wxyhaha/FlipPomodoroTimer/hardware/enclosure/FINAL-DIMENSIONS-V12.9.md

# V12.9 最终名义尺寸核对与下单文件

本次仅把两个压条前舌加长并将对应盲槽改为通孔。通孔下方增加拆装让位，不改上沿防抬位置。与V12.8的实体布尔差异检查显示，主壳与压条的差异全部在这两个卡口区域，后盖几何差异为零。详细记录见 `scope-check.json`。这是一份模型核查，不是实物或代打精度保证。

## 最新正式打印件

`hardware/enclosure/v12.9/` 中，以下三件各打印1个，单位mm：

| 文件 | 部件 | 打印摆放包络（mm） |
| --- | --- | --- |
| V12.9-shell.stl | 一体主壳，包含托槽、导轨和螺丝座 | 90.5×92.5×90.5 |
| V12.9-lid.stl | 四螺丝后盖 | 90.5×92.5×6 |
| V12.9-retainer.stl | 一件U形电池压条 | 50×57.8×19.3 |

正式文件是源码输出 `v12/*-print.stl` 的同几何版本命名副本。三个打印件均已摆放落在Z=0，全部为单一封闭实体；试样、装配坐标版本和GLB不得重复当正式件下单。

## 尺寸清单

| 项目 | 名义尺寸/间隙 |
| --- | --- |
| 总装包络（宽×深×高） | 90.5×94.5×92.5mm |
| 目标面板 | 86.5×86.5×14.5mm |
| 面板内缩 | 3mm |
| 面板槽 | 高86.90mm、前后深14.90mm；上下、前后每侧0.2mm |
| 面板左侧 | 上、下各4mm止挡；左缘名义间隙0.05mm；中部78.5mm开放 |
| 面板后侧导轨 | 上下各搭边2mm；后隙0.2mm；右侧约0.3mm导入斜口 |
| 前框 | 前口78mm，最窄内口72.8mm；圆角内口R0.8mm |
| 官方显示区 | 71.93×71.93mm，按居中建模；直边余量每侧0.435mm |
| 电池 | 含包膜66.7×37.3×20mm；左右各约0.8mm，前端2.8mm、后端0.8mm余量 |
| 电池压条 | 两条臂宽6mm、厚2.5mm；电池顶面间隙0.5mm |
| 新长舌 | 两个，宽6mm、厚1.2mm；从内侧立臂向前伸3mm，穿过2mm挡边，外露1mm；根部另有0.1mm连接重叠 |
| 新通孔 | 宽6.6mm、高2.4mm；舌片左右各0.3mm、上方0.2mm、下方1.0mm装拆让位 |
| 长舌尖到面板背面 | 约9.7mm（不含实际插座和线束） |
| 压条立臂到电池前侧 | 约1.3mm（就位状态） |
| 后盖 | 外板厚4mm；定位边伸入2mm、名义单边间隙0.3mm |
| 螺丝 | 塑料用自攻外径约3mm×头下长10mm，共6颗：后盖4、压条2；不使用螺母 |
| 螺丝孔 | 通孔3.2mm、导孔2.5mm；后盖沉台6.4mm直径×2.2mm深；螺丝头要求直径≤6mm、高≤2mm |

## 检查结果和实际限制

- 三件封闭、正体积、各单一实体；装配位置的实体之间及对面板/电池标称包络均无正体积穿插。
- 面板右侧三个插入位置检查通过，向左0.2mm移动会被止挡阻挡；后移超过0.2mm的检查会被后导轨限制。
- 新通孔贯通检查、尺寸和范围差异检查通过；面板后侧到电池仓的九条射线贯通。
- 屏幕9种正视偏移场景无挡；81种全部场景中，14种极限偏移叠加30°斜视仍有少量遮边，用户已接受，开口未改。
- 压条拆装检查使用移开面板、后盖的顺序，并把电池近似为20mm厚、37.3mm宽、66.7mm长的圆柱包络。1071个采样姿态未发现穿插，可逆向用于装配。不是带实际线束、包膜起伏和手部操作的实物验证。
- 长舌需要先插前端、再落后端并上两颗螺丝；拆卸先移开面板和后盖、卸压条螺丝，逐步倾斜并后退，再从后方取出。不能把“露出1mm”理解为可以平着强拉3mm，也不能强掰树脂舌片。
- 面板右端仍没有防退出锁，打印收缩、胶膜、线束、螺丝攻入及材料强度没有实物验证。几何检查不能保证打印后免修配；这些既有结构未在本次修改中调整。
