wxyhaha/FlipPomodoroTimer/docs/CODE-REVIEW-2026-11-06.md

# 固件检查与当前限制

固件实现已覆盖计时状态、电源、触摸、显示和音频的主要交互；当前功能及实际验证范围见[功能状态与验收说明](UI-V6-VALIDATION.md)。

仍需注意：RTC 底层 I2C 读取错误未完整向应用层传播；充电电流、完整充电周期与续航尚未实测；屏幕、音频和电源相关并发行为仍需在完整设备上进一步覆盖。编译及短时运行不等同于所有场景均已通过。
