wxyhaha/FlipPomodoroTimer/docs/PLAN.md

# 项目成果与复现状态

项目已形成立式翻转番茄钟实物：触摸屏开发板、电池组、定制打印主壳、后盖和电池压条已装配；实物照片与演示见[项目首页](../README.md)。

| 内容 | 当前状态 |
| --- | --- |
| 番茄钟、时钟页与翻面 | 固件已实现，视频展示翻面切换、显示旋转和页面切换 |
| 用户输入与提示音 | 触摸、BOOT、PWRKEY、电钢琴提示音均已实现；具体操作见首页和[提示音说明](AUDIO.md) |
| 电池与 USB | 已观察短时电池供电和 USB 接入时芯片报告充电；完整充电周期、实际电流、容量与续航未测 |
| 外壳 | X 树脂外壳已打印并装配；实物照片展示内部与后盖，长期防脱、螺丝配合和线束可靠性仍需验证 |
| 最新固件 | 已编译并烧录，写入校验通过；USB 插拔规则、电量图标及动画在更多场景下仍需实机验收 |

## 构建配置

使用 Arduino CLI 1.5.1、`esp32:esp32@3.3.11`，目标 `esp32:esp32:esp32s3`，Flash 16MB、OPI PSRAM，仓库本地依赖通过 `--libraries firmware/libraries` 指定。完整命令与 Wi-Fi 本地配置说明见[项目首页](../README.md)。

公开分发二进制之前，应在不含 `WiFiConfig.local.h` 的环境构建；项目许可证、第三方库与字库许可、干净环境复现仍需另行核实。
