wxyhaha/FlipPomodoroTimer/docs/design/UI-DESIGN.md

# 最终界面

番茄钟页采用 20 段彩色时间环与自绘数码字；时钟页采用大号时分、小号秒数、中文日期和星期。顶部左右分别为番茄钟和时钟入口，中间显示电池状态及百分比，左下角提供息屏入口。

显示方向根据姿态旋转，静止状态使用局部刷新；动画使用较小纹理以兼顾性能，最终画面恢复原生分辨率。实际画面和操作请看[成品照片与演示](../../README.md)，具体验证边界见[功能状态与验收说明](../UI-V6-VALIDATION.md)。
