wxyhaha/FlipPomodoroTimer/docs/design/timer-clock-ui-v2.png

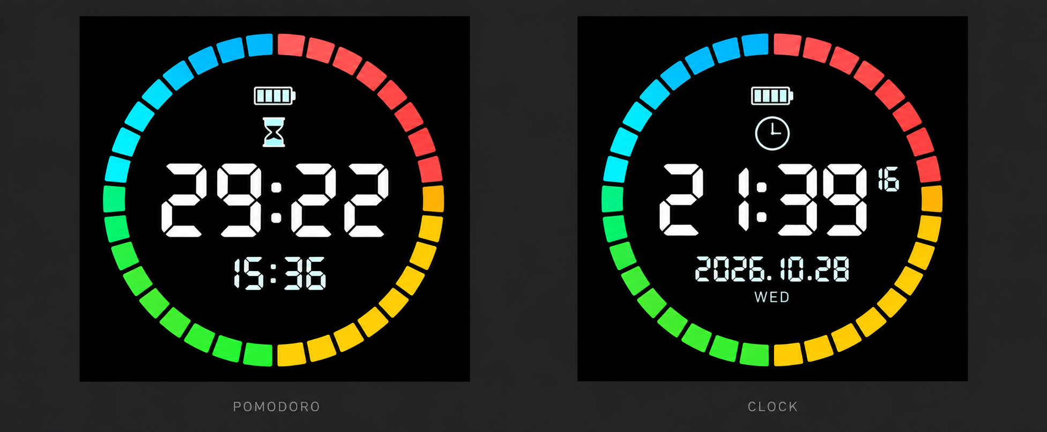
docs/design/timer-clock-ui-v2.png
