wxyhaha/FlipPomodoroTimer/docs/design/timer-clock-ui-v3.png

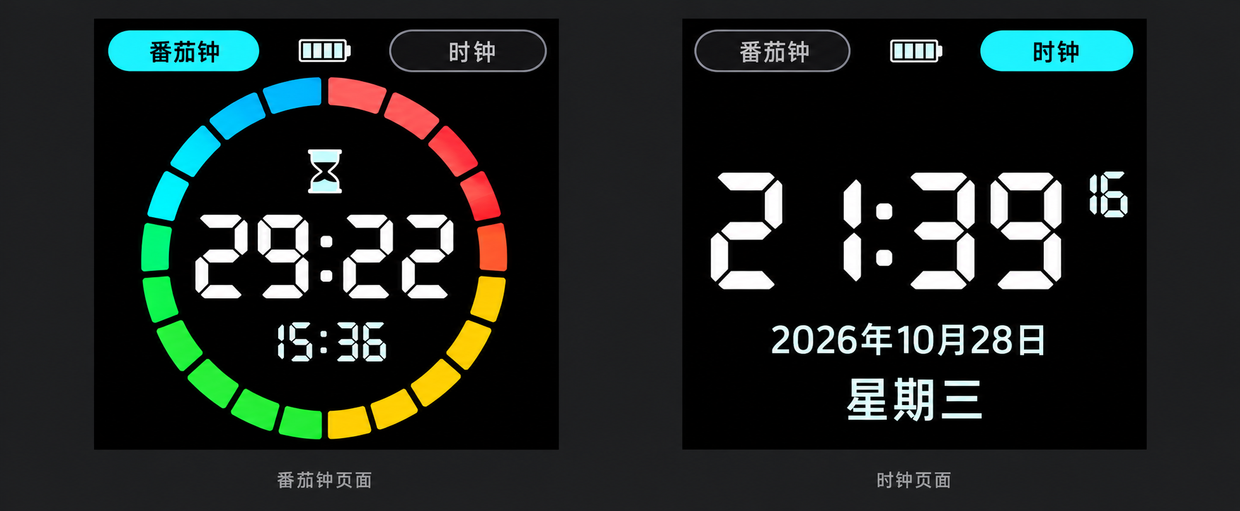
docs/design/timer-clock-ui-v3.png
