wxyhaha/FlipPomodoroTimer/docs/design/timer-clock-ui-v4.png

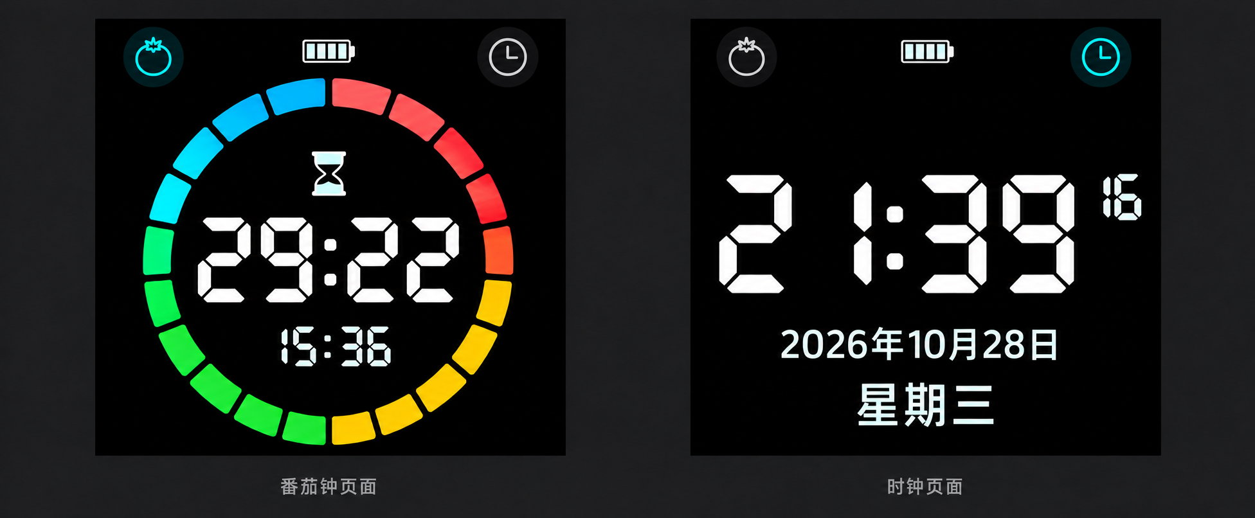
docs/design/timer-clock-ui-v4.png
