wxyhaha/FlipPomodoroTimer/docs/design/timer-ui-v1.png

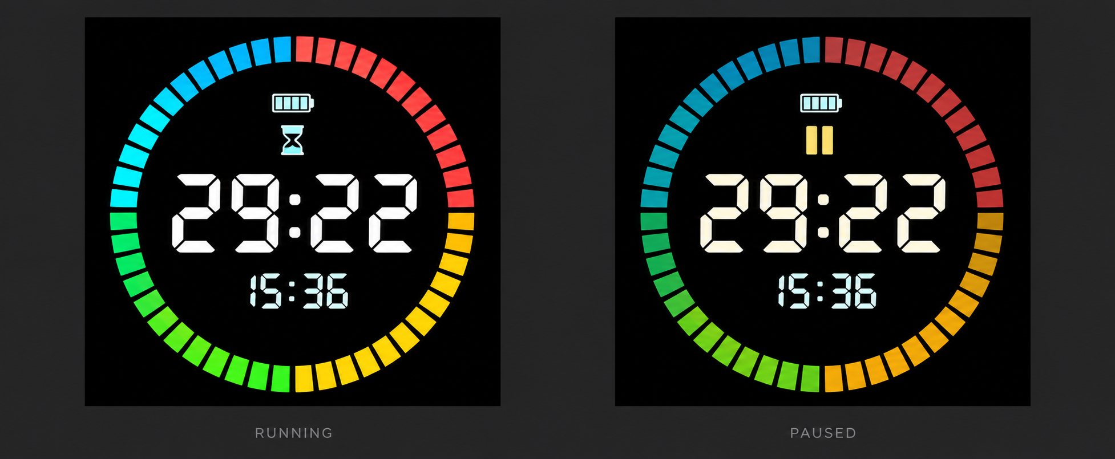
docs/design/timer-ui-v1.png
