wxyhaha/FlipPomodoroTimer/hardware/enclosure/enclosure-v0.png

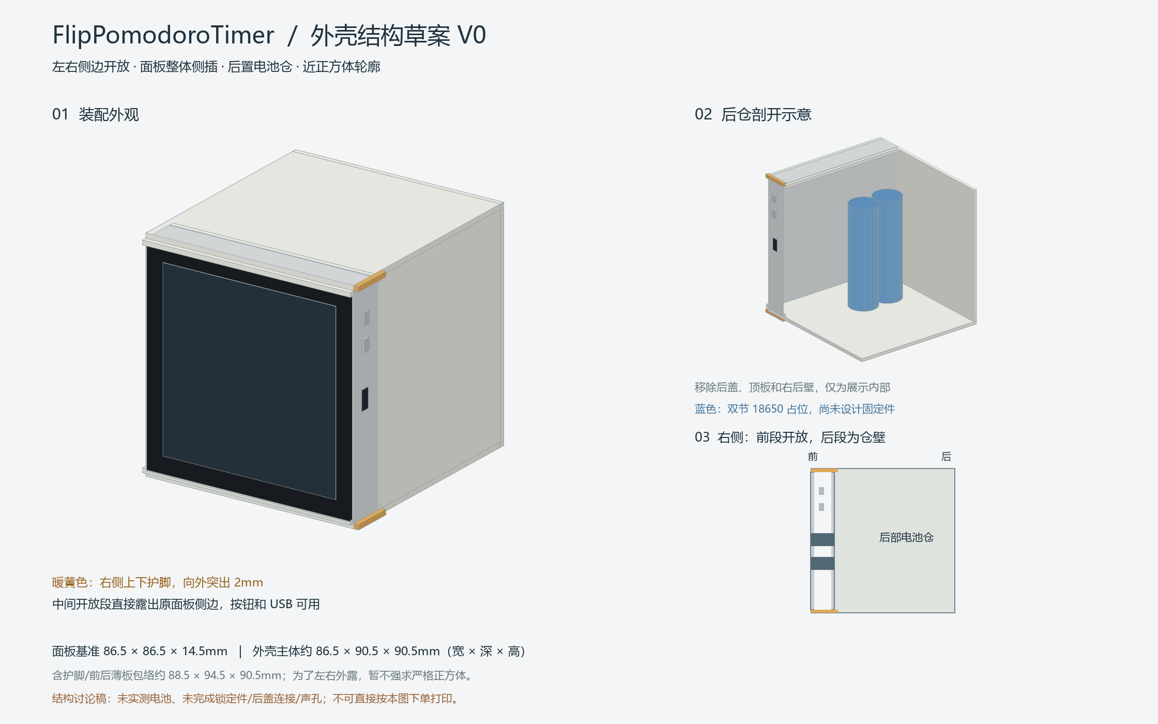
hardware/enclosure/enclosure-v0.png
