wxyhaha/FlipPomodoroTimer/hardware/enclosure/v12.9/V12.9-shell.stl

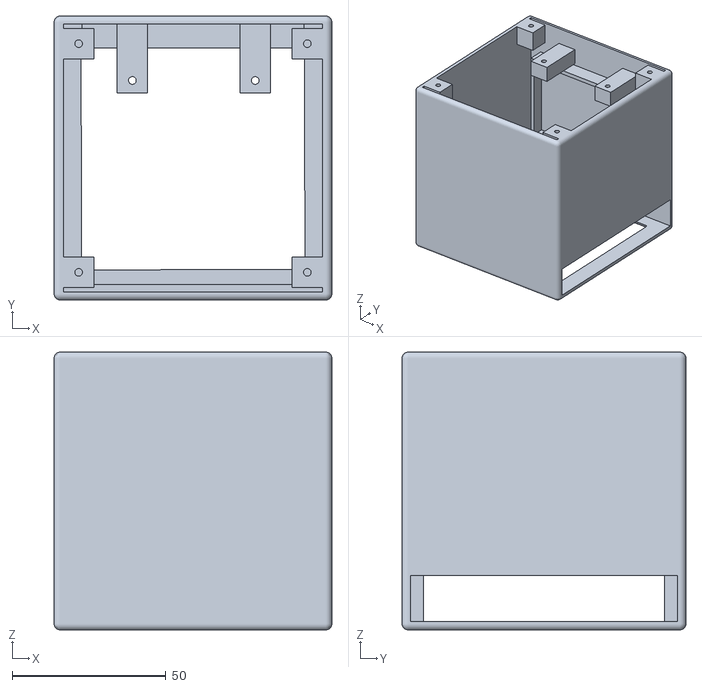
[picture p14: CAD file, 2026-11-03]
hardware/enclosure/v12.9/V12.9-shell.stl
90.5 x 92.5 x 90.5
