wxyhaha/FlipPomodoroTimer/hardware/enclosure/v12.9/V12.9-lid.stl

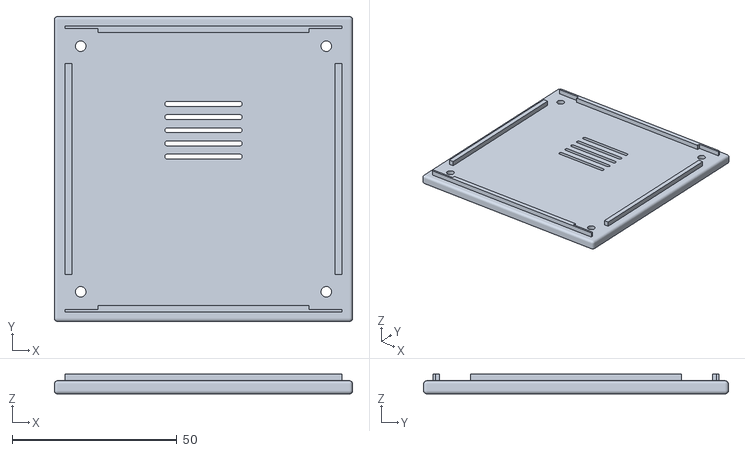
[picture p15: CAD file, 2026-11-03]
hardware/enclosure/v12.9/V12.9-lid.stl
90.5 x 92.5 x 6.00
