wxyhaha/FlipPomodoroTimer/hardware/enclosure/v12/retainer-assembly.stl

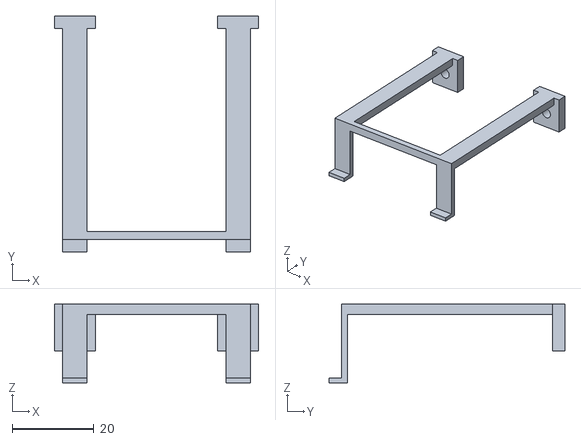
[picture p16: CAD file, 2026-11-03, an earlier design]
hardware/enclosure/v12/retainer-assembly.stl
50.0 x 57.8 x 19.3
