wxyhaha/FlipPomodoroTimer/hardware/enclosure/v12/fit-tongue.stl

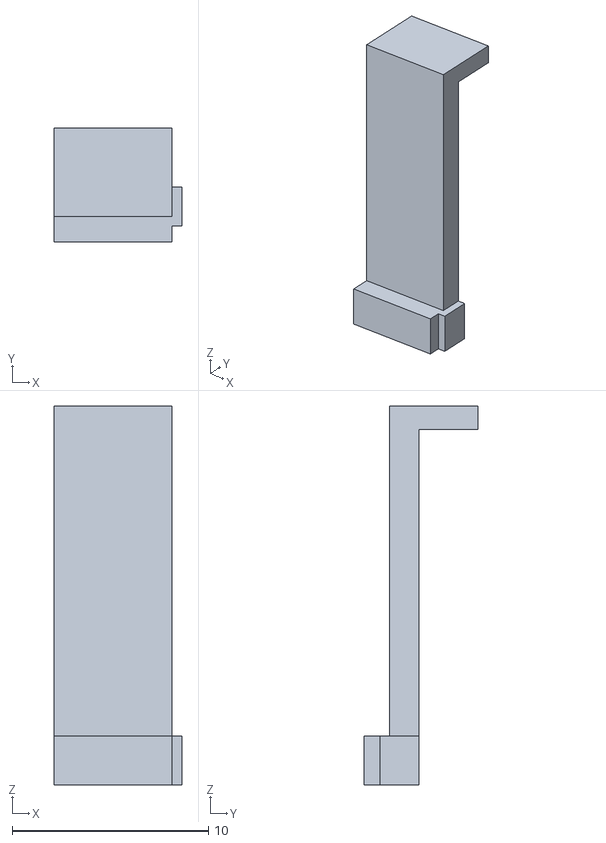
[picture p17: CAD file, 2026-11-03, an earlier design]
hardware/enclosure/v12/fit-tongue.stl
6.50 x 5.80 x 19.3
