wxyhaha/FlipPomodoroTimer/hardware/enclosure/v12/fit-rail.stl

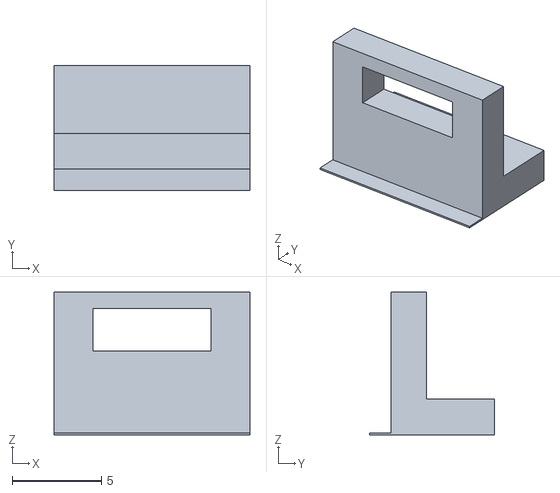
[picture p18: CAD file, 2026-11-03, an earlier design]
hardware/enclosure/v12/fit-rail.stl
11.0 x 7.00 x 8.00
