wxyhaha/FlipPomodoroTimer/hardware/enclosure/v12/fit-panel-guide.stl

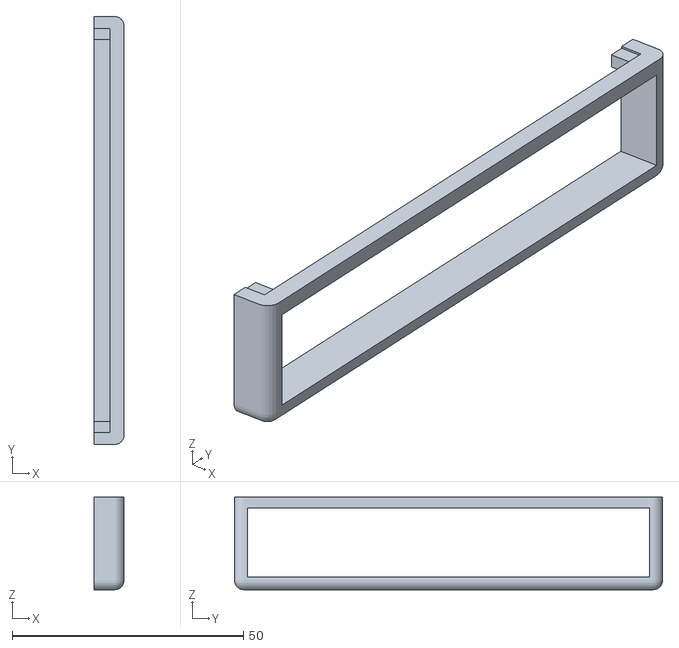
[picture p19: CAD file, 2026-11-03, an earlier design]
hardware/enclosure/v12/fit-panel-guide.stl
6.50 x 92.5 x 20.0
