wxyhaha/FlipPomodoroTimer/hardware/enclosure/v12/fit-panel-slot.stl

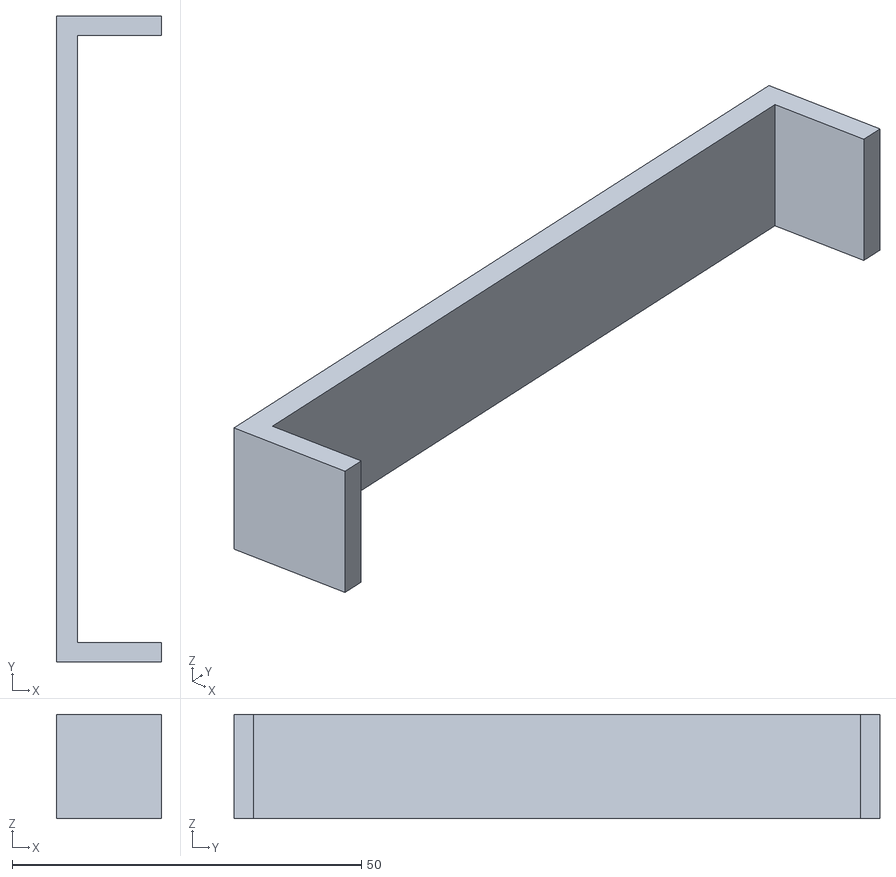
[picture p20: CAD file, 2026-11-03, an earlier design]
hardware/enclosure/v12/fit-panel-slot.stl
15.0 x 92.5 x 14.9
