wxyhaha/FlipPomodoroTimer/hardware/enclosure/v12/fit-screws.stl

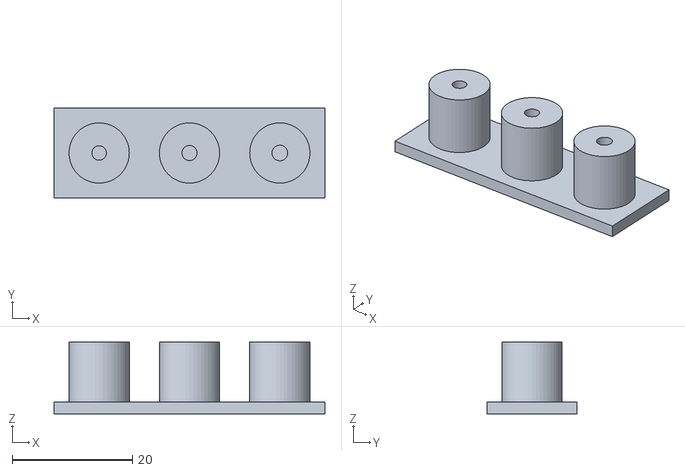
[picture p21: CAD file, 2026-11-03, an earlier design]
hardware/enclosure/v12/fit-screws.stl
45.0 x 15.0 x 11.9
