wxyhaha/FlipPomodoroTimer/(list of files, cad)

Other CAD files:
hardware/enclosure/v12/shell-assembly.stl
hardware/enclosure/v12/lid-assembly.stl
hardware/enclosure/v12/retainer-print.stl
hardware/enclosure/enclosure-v0.scad
hardware/enclosure/enclosure-v1.scad
hardware/enclosure/enclosure-v10.scad
hardware/enclosure/enclosure-v2.scad
hardware/enclosure/enclosure-v3.scad
hardware/enclosure/enclosure-v4.scad
hardware/enclosure/enclosure-v5.scad
hardware/enclosure/enclosure-v6.scad
hardware/enclosure/enclosure-v7.scad
hardware/enclosure/enclosure-v8.scad
hardware/enclosure/enclosure-v9.scad
