wxyhaha/FlipPomodoroTimer/docs/UI-V5-VALIDATION.md

# 界面与验收

当前界面与验证状态统一见[功能状态与验收说明](UI-V6-VALIDATION.md)，实物照片及演示见[项目首页](../README.md)。
