wxyhaha/FlipPomodoroTimer/firmware/FlipPomodoroTimer/FlipPomodoroTimer.ino

#include <Arduino.h>
#include <Wire.h>
#include "pin_config.h"
#include "PomodoroState.h"
#include "IMUSensor.h"
#include "PowerManager.h"
#include "DisplayUI.h"
#include "InputManager.h"
#include "AudioManager.h"
#include "RTCManager.h"

#include "WiFiConfig.h"

// Wi-Fi 配置来自忽略的本地文件；未配置时离线运行。



PomodoroEngine engine;
IMUSensor imu;
PowerManager power;
DisplayUI ui;
InputManager input;
AudioManager audio;
RTCManager rtc;

unsigned long lastTelemetryTime = 0;
bool stableVbusIn = false;
bool candidateVbusIn = false;
bool startIdleTimerAfterUnplug = false;
unsigned long vbusCandidateSince = 0;
constexpr unsigned long USB_MODE_DEBOUNCE_MS = 1000;

void updateUsbMode(unsigned long now) {
  if (power.vbusIn != candidateVbusIn) {
    candidateVbusIn = power.vbusIn;
    vbusCandidateSince = now;
  }

  if (candidateVbusIn == stableVbusIn || now - vbusCandidateSince < USB_MODE_DEBOUNCE_MS) return;

  stableVbusIn = candidateVbusIn;
  if (stableVbusIn) {
    startIdleTimerAfterUnplug = false;
    if (engine.state == STATE_FOCUS_RUNNING || engine.state == STATE_BREAK_RUNNING) {
      // USB power must not interrupt an active countdown or change its page.
      Serial.println("[POWER] USB connected during countdown; keep timer and page");
    } else {
      ui.setMode(UI_MODE_CLOCK);
      Serial.println("[POWER] Stable USB input -> Clock page");
    }
  } else {
    if (engine.pauseReason == PAUSE_BY_USB) engine.pauseReason = PAUSE_BY_USER;
    ui.setMode(UI_MODE_POMODORO);
    startIdleTimerAfterUnplug = engine.state == STATE_IDLE;
    Serial.println("[POWER] USB input removed -> Pomodoro page");
  }
}

void setup() {
  Serial.begin(115200);
  delay(300);

  Serial.println("\n==================================================");
  Serial.println("  Cube Flip Clock & Timer (ESP32-S3-Touch-LCD-4B)");
  Serial.println("==================================================");

  // 1. 初始化 I2C 总线
  Wire.begin(BOARD_I2C_SDA, BOARD_I2C_SCL);

  // 2. 初始化显示屏 (原生全中文支持，480x480 RGB)
  Serial.print("Init Display... ");
  if (ui.init()) {
    Serial.println("OK");
    ui.showBootScreen();
  } else {
    Serial.println("FAILED!");
  }

  // 3. 初始化电源管理 (AXP2101 + 100% 满血高亮背光)
  Serial.print("Init Power Manager... ");
  if (power.init()) {
    Serial.println("OK");
  } else {
    Serial.println("FAILED!");
  }

  // 4. 初始化硬件 RTC 并通过 Wi-Fi NTP 自动授时
  Serial.print("Init RTC & WiFi NTP Sync... ");
  if (rtc.init()) {
    Serial.println("OK");
    // 尝试连接用户 Wi-Fi 并同步网络时间，授时完成后立即关闭 Wi-Fi 节能
    rtc.syncTimeWithWiFi(WIFI_SSID, WIFI_PASS, 8000);
  } else {
    Serial.println("FAILED!");
  }

  // 5. 初始化六轴姿态传感器 (QMI8658 陀螺仪与加速度计)
  Serial.print("Init QMI8658 IMU... ");
  if (imu.init()) {
    Serial.println("OK");
  } else {
    Serial.println("FAILED!");
  }

  // 7. 初始化触控与按键 (GT911 & BOOT Pin)
  Serial.print("Init Input (Touch & Button)... ");
  if (input.init()) {
    Serial.println("OK");
  } else {
    Serial.println("FAILED!");
  }

  // 8. 初始化音频提示 (ES8311 Codec 最大音量提示音)
  Serial.print("Init Audio (ES8311 Codec)... ");
  if (audio.init(ui.getExpander())) {
    Serial.println("OK");
  } else {
    Serial.println("DISABLED/NOT FOUND");
  }

  // 9. 初始化番茄钟状态机
  engine.begin();

  // Startup page follows the current USB input; timer state remains independent.
  stableVbusIn = candidateVbusIn = power.vbusIn;
  vbusCandidateSince = millis();
  ui.setMode(stableVbusIn ? UI_MODE_CLOCK : UI_MODE_POMODORO);

  // 根据启动时的初始姿态自动校准屏幕显示方向
  uint8_t initialRotation = imu.getDisplayRotation(0);
  ui.setRotation(initialRotation);
  input.setRotation(initialRotation);

  if (imu.isFlippedDown()) ui.setPanelOutputOff(true, power);
  delay(400);

  // 首次完整绘制拟真科技感全界面
  ui.fullRedraw(engine, imu, power, rtc);
  Serial.println("System Ready! UI V6.2 - full panel off, PWRKEY double-click shutdown.\n");
}

void loop() {
  unsigned long now = millis();

  // Sound cues are dispatched once, after all state changes in this loop.
  TimerState stateAtLoopStart = engine.state;
  uint8_t faceAtLoopStart = engine.activeFace;
  engine.tick(now);

  // Optional serial speaker check; no changes to timer duration/state.
  static char command[24] = {};
  static uint8_t commandLength = 0;
  for (int budget = 0; budget < 32 && Serial.available(); ++budget) {
    char c = Serial.read();
    if (c == '\n' || c == '\r') {
      command[commandLength] = 0;
      if (!strcmp(command, "AUDIO_TEST")) audio.playTest();
      commandLength = 0;
    } else if (commandLength < sizeof(command) - 1) command[commandLength++] = c;
    else commandLength = 0;
  }

  // 2. 轮询电源状态（USB 插拔、电量）
  power.update();
  if (power.updatePowerKeyDoubleClick(now)) {
    Serial.println("[POWER] PWRKEY double-click -> full shutdown");
    audio.stop();
    power.shutdown();
  }
  bool previousStableVbus = stableVbusIn;
  updateUsbMode(now);

  // 3. 推进硬件 RTC 时间走时
  rtc.update(now);

  // 4. 轮询姿态传感器（125Hz 采样与 600ms 滤波）
  bool oriChanged = imu.update();

  // Visual direction is independent of the 600ms timer-face confirmation.
  uint8_t targetRot = imu.getVisualRotation(ui.getRotation());
  if (targetRot != ui.getRotation()) {
    ui.setRotation(targetRot);
    input.setRotation(targetRot);
    Serial.printf("[DISPLAY] 2D direction -> %u deg\n", targetRot * 90);
  }

  // 6. 姿态发生稳态切换事件
  if (oriChanged) {
    Serial.printf("[IMU] Orientation Changed -> %s (ax=%.2f, ay=%.2f, az=%.2f, roll=%.1f deg)\n",
                  imu.getOrientationName(), imu.ax, imu.ay, imu.az, imu.smoothRollAngle);

    if (imu.isFlippedDown()) {
      ui.setPanelOutputOff(true, power);
      // 动作：设备屏幕完全朝下盖在桌面上，关闭显示输出并暂停计时。
      if (engine.state == STATE_FOCUS_RUNNING || engine.state == STATE_BREAK_RUNNING) {
        Serial.println("[POMO] Auto Pause by Flip Down (Panel Off)");
        engine.pause(PAUSE_BY_FLIP);
      } else if (engine.state == STATE_COMPLETED) {
        Serial.println("[POMO] Confirm Completed by Flip Down");
        engine.confirmCompleted();
      }
    } else if (imu.isBackwardPaused()) {
      // 动作：向后翻转平放在桌面上（用户核心需求：向后翻转暂停，保持 100% 满血高亮以便看清状态）
      if (!ui.isManualScreenOff()) ui.setPanelOutputOff(false, power);
      if (engine.state == STATE_FOCUS_RUNNING || engine.state == STATE_BREAK_RUNNING) {
        Serial.println("[POMO] Auto Pause by Backward Flip!");
        engine.pause(PAUSE_BY_FLIP);
      } else if (engine.state == STATE_COMPLETED) {
        Serial.println("[POMO] Confirm Completed by Backward Flip");
        engine.confirmCompleted();
      }
    } else if (imu.isTiltedFace()) {
      // 动作：设备立在 4 个侧立面之一
      if (!ui.isManualScreenOff()) ui.setPanelOutputOff(false, power);
      uint8_t face = imu.getFaceIndex();
      unsigned long faceSec = imu.getFaceDurationSec();

      // 番茄钟页立到新面或待机/完成后重新立起时，切换到该面的独立倒计时。
      if (ui.getMode() == UI_MODE_CLOCK || engine.pauseReason == PAUSE_BY_USB) {
        // 时钟页下翻面只更新屏幕方向，不启动隐藏倒计时或切换页面；
        // USB 自动暂停期间移动也不覆盖保留的剩余时间。
      } else if (engine.activeFace != face || engine.state == STATE_IDLE || engine.state == STATE_COMPLETED) {
        Serial.printf("[POMO] Tilt to New Face %u (%lu sec) -> Start Timer!\n", face, faceSec);
        engine.startFace(face, faceSec);

      } else if ((engine.state == STATE_FOCUS_PAUSED || engine.state == STATE_BREAK_PAUSED) &&
                 engine.pauseReason == PAUSE_BY_FLIP) {
        // 同一个面从暂停中重新立起恢复
        Serial.printf("[POMO] Tilt back to Same Face %u -> Resume Timer!\n", face);
        engine.resume();
      }
    }
  }

  // A face may already be stable when USB is removed, so no orientation-change
  // event will arrive. Wait for a confirmed side rather than starting while moving.
  if (startIdleTimerAfterUnplug) {
    if (stableVbusIn || engine.state != STATE_IDLE || ui.getMode() != UI_MODE_POMODORO) {
      startIdleTimerAfterUnplug = false;
    } else if (imu.isReady && imu.isTiltedFace() &&
               imu.candidateOrientation == imu.currentOrientation &&
               millis() - imu.candidateStartTime >= IMUSensor::STABLE_DURATION_MS) {
      engine.startFace(imu.getFaceIndex(), imu.getFaceDurationSec());
      startIdleTimerAfterUnplug = false;
      Serial.println("[POMO] USB removed -> start current stable face");
    }
  }

  // 7. 轮询触摸与物理按键输入
  if (ui.isAnimating()) input.cancelTouch();
  UserAction action = input.update();
  if (action == ACTION_TAP && ui.isAnimating() && !input.lastTapFromButton) {
    action = ACTION_NONE; // Ignore moving touch targets until rotation settles.
  }
  if (action == ACTION_TAP) {
    Serial.printf("[USER] Tap Event at (%d, %d)\n", input.lastTapX, input.lastTapY);

    // A tap while blank only wakes the display; it must not also toggle the timer.
    if (ui.isManualScreenOff()) {
      ui.setManualScreenOff(false);
      if (!imu.isFlippedDown()) ui.setPanelOutputOff(false, power);
      Serial.println("[UI] Wake display by touch");
    } else if (ui.checkScreenOffClick(input.lastTapX, input.lastTapY)) {
      ui.setManualScreenOff(true);
      ui.setPanelOutputOff(true, power);
      Serial.println("[UI] Manual panel off; tap anywhere to wake");
    } else {
      int clickedMode = ui.checkBadgeClick(input.lastTapX, input.lastTapY);
      if (clickedMode >= 0 && !input.lastTapFromButton) {
        if (clickedMode != (int)ui.getMode()) {
          ui.setMode((UIMode)clickedMode);
          Serial.printf("[UI] Mode Switched to %s\n", (clickedMode == UI_MODE_CLOCK) ? "CLOCK" : "POMODORO");
          audio.playClickTone();
        }
      } else if (input.lastTapFromButton || ui.getMode() == UI_MODE_POMODORO) {
        // Timer page tap / physical BOOT toggles timer; clock page background is inert.
        engine.toggle();
        if (engine.state != STATE_FOCUS_RUNNING && engine.state != STATE_BREAK_RUNNING) audio.playClickTone();
      }
    }
  } else if (action == ACTION_LONG_PRESS) {
    Serial.println("[USER] Long Press Event -> RESET TIMER");
    audio.stop();
    audio.playClickTone();
    engine.reset();

  }

  bool wasRunning = stateAtLoopStart == STATE_FOCUS_RUNNING || stateAtLoopStart == STATE_BREAK_RUNNING;
  bool running = engine.state == STATE_FOCUS_RUNNING || engine.state == STATE_BREAK_RUNNING;
  if (stateAtLoopStart == STATE_COMPLETED && engine.state != STATE_COMPLETED) audio.stopCompletion();
  if (running && (!wasRunning || engine.activeFace != faceAtLoopStart)) audio.playStartTone();
  if (engine.state == STATE_COMPLETED && stateAtLoopStart != STATE_COMPLETED) {
    Serial.println("[ALERT] Countdown finished; queue 2.1 second soft piano cue");
    audio.playCompletionChime();
  }

  // Once completed, blank the display after 30 seconds without interaction.
  // Waking or changing page/pose starts a new inactivity interval.
  static unsigned long completedActivityMs = 0;
  if (engine.state == STATE_COMPLETED) {
    if (stateAtLoopStart != STATE_COMPLETED || action != ACTION_NONE || oriChanged ||
        previousStableVbus != stableVbusIn) {
      completedActivityMs = millis();
    } else if (!ui.isManualScreenOff() && millis() - completedActivityMs >= 30000UL) {
      ui.setManualScreenOff(true);
      ui.setPanelOutputOff(true, power);
      Serial.println("[UI] Completion inactivity -> panel off");
    }
  }

  // 持续刷新二维界面，翻面方向由姿态事件切换。
  ui.update(engine, imu, power, rtc);

  // 9. 周期性串口遥测输出（每 1 秒打印一次状态）
  if (now - lastTelemetryTime >= 1000) {
    lastTelemetryTime = now;
    unsigned long rem = engine.getRemainingSeconds();
    Serial.printf("[STATUS] Mode: %s | Time: %02lu:%02lu | RTC: %s | Face: %u (Rot:%u) | State: %d | Ori: %s | VBUS: %umV | Batt: %umV (%d%%)\n",
                  (ui.getMode() == UI_MODE_CLOCK) ? "CLOCK" : "POMO",
                  rem / 60, rem % 60, rtc.getTimeString(), engine.activeFace, ui.getRotation(),
                  engine.state, imu.getOrientationName(),
                  power.vbusVoltageMv, power.battVoltageMv, power.batteryPercent);
  }

  delay(ui.isAnimating() ? 1 : 10);
}
