wxyhaha/FlipPomodoroTimer/firmware/FlipPomodoroTimer/DigitFont.h

// Generated native-size glyphs; tools/generate_digit_font.py; original artwork.
#pragma once
#include <stdint.h>
static const uint8_t DIGITS_64_104[10][6656] = {
  {
    0,0,0,0,0,0,0,0,0,0,0,48,191,255,255,255,255,255,255,255,255,255,255,255,255,255,255,255,255,255,255,255,255,255,255,255,255,255,255,255,255,255,255,255,255,255,255,255,255,255,255,191,48,0,0,0,0,0,0,0,0,0,0,0,
    0,0,0,0,0,0,0,0,0,32,159,255,255,255,255,255,255,255,255,255,255,255,255,255,255,255,255,255,255,255,255,255,255,255,255,255,255,255,255,255,255,255,255,255,255,255,255,255,255,255,255,255,255,159,32,0,0,0,0,0,0,0,0,0,
    0,0,0,0,0,0,0,16,128,239,255,255,255,255,255,255,255,255,255,255,255,255,255,255,255,255,255,255,255,255,255,255,255,255,255,255,255,255,255,255,255,255,255,255,255,255,255,255,255,255,255,255,255,255,239,128,16,0,0,0,0,0,0,0,
    0,0,0,0,0,0,96,239,255,255,255,255,255,255,255,255,255,255,255,255,255,255,255,255,255,255,255,255,255,255,255,255,255,255,255,255,255,255,255,255,255,255,255,255,255,255,255,255,255,255,255,255,255,255,255,255,239,96,0,0,0,0,0,0,
    0,0,0,0,64,223,255,255,255,255,255,255,255,255,255,255,255,255,255,255,255,255,255,255,255,255,255,255,255,255,255,255,255,255,255,255,255,255,255,255,255,255,255,255,255,255,255,255,255,255,255,255,255,255,255,255,255,255,223,64,0,0,0,0,
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
    255,255,255,255,255,255,255,255,255,255,255,255,0,0,0,0,0,0,0,0,0,0,0,0,0,0,0,0,0,0,0,0,0,0,0,0,0,0,0,0,0,0,0,0,0,0,0,0,0,0,0,0,0,0,0,0,0,0,0,0,0,0,0,0,0,0,0,0,0,0,
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
