wxyhaha/FlipPomodoroTimer/(commit log)

2026-10-28 feat: 完成翻转番茄钟首版固件并实机验证通过
    - 驱动微雪 ESP32-S3-Touch-LCD-4B 硬件，完成 ST7701 480x480 RGB 屏幕驱动与高画质局部抗闪烁 UI 渲染
    - 实现 PomodoroState 单调时钟防漂移状态机，支持 25min 专注与 5min 休息循环
    - 集成 QMI8658 六轴姿态传感器与 600ms 滑动窗口防抖滤波，实现翻转盖下自动暂停与熄灭背光省电、翻回正面自动亮屏恢复
    - 集成 GT911 电容触摸与板载 BOOT 按键双模交互（单击启停、长按 1.5s 安全复位）
    - 集成 AXP2101 PMIC 电源监控与安全充电限流，初始化 ES8311 音频子系统
    - 建立 arduino-cli 纯命令行本地编译与烧录工具链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
2026-10-28 feat: 实现全中文原生显示、四面独立倾角倒计时与体验全面升级
    本次升级解决了实机反馈的乱码、背光偏暗、每秒闪烁与点击跳动问题，并正式交付四面独立倾角倒计时与最大音量提示音：
    1. 全中文原生显示：
    - 启用 Arduino_GFX 原生 U8g2 UTF-8 字库引擎（u8g2_font_unifont_t_chinese4，覆盖 7199 个标准汉字），开启 setUTF8Print(true)；
    - 界面全中文排版（包括「专注计时中」、「休息进行中」、「正面平放」、「面二(15分)」等），彻底解决原固件 ASCII 字体解析中文导致的乱码。
    2. 100% 满血高亮背光控制：
    - 修正 PowerManager.h 中的背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
2026-10-28 feat: 支持向后翻转暂停与重力屏幕自适应旋转并修复中文显示
    1. 汉字显示修复：
    - 在 GFX_Library_for_Arduino 的 Arduino_GFX.h 中开启 U8G2_WITH_UNICODE 与 U8G2_USE_LARGE_FONTS 编译宏，打通 Unicode 编码通道；
    - 完整解码并显示 u8g2_font_unifont_t_chinese4 中的 7199 个标准汉字，消除空白与乱码。
    2. 纠正翻转暂停为向后翻转平放：
    - 优化 QMI8658 加速度计姿态分类，将向后推倒平放桌面（屏幕朝上仰卧，az <= -0.50g）识别为 ORIENTATION_BACKWARD_PAUSE 并触发暂停；
    - 保持 100% 满血背光以便看清暂停状态与已完成轮数，重新立起原面自动恢复倒计时；
    - 保留完全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
2026-10-28 feat: 实现拟真立方体翻转时钟UI、硬件RTC与3D物理透视引擎
    本次升级全面对标视频中的立方体桌面翻转时钟产品，重塑视觉体系并升级底层动力学与授时架构：
    1. 硬件 RTC 走时与 Wi-Fi NTP 自动授时：
    - 驱动板载 PCF85063 硬件日历时钟芯片（I2C 地址 0x51）；
    - 开机连接用户 Wi-Fi 并向 NTP 服务器（阿里云/pool.ntp.org）同步北京时间（GMT+8），精准写入 RTC 硬件寄存器；
    - 授时完成后立即切断 Wi-Fi 射频，消除发热并节能；在屏幕正下方以深色拟物药丸胶囊框常驻精准显示真实时间。
    2. 四面预设时长更新：
    - 匹配实体产品的四面时长：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
2026-10-28 fix: 优化显示刷新与翻面动画
    实现二十段四主色圆环、原生尺寸数码字及沙漏和时钟图标切页，移除三维透视与冗余界面信息。
    采用局部更新、双缓冲释放同步和轻量二维旋转，减少闪动与动画卡顿，并记录用户实机验收反馈。
    将 Wi-Fi 凭证移至忽略的本地配置，提供离线默认入口和配置示例，避免公开私人网络信息。
    同步硬件说明、开发计划、设计稿、本地依赖补丁与验证记录，完善复现资料。
2026-10-29 fix: 修复断电黑屏并完善计时提示音
    纠正 TCA9554 构造参数和地址，使 LCD 初始化与功放使能正常；增加开始短音和完成长音，后台播放避免阻塞界面，并提供串口喇叭测试。同步更新复现、硬件、开发计划和音频验收文档；已检查全部十份项目 Markdown，编译烧录及画面声音测试通过，用户确认断电重插显示正常，完整计时到期与快速切换抢占仍待验证。
2026-11-03 feat: 完善番茄钟交互与外壳复现资料
    增加 USB 自动切页与计时暂停、柔和电钢琴提示音、完整息屏及 PWRKEY 双击关机；补充硬件文档，并加入 V12.9 外壳源码、校验资料和三件打印 STL。固件已编译并烧录校验，息屏、双击关机及外壳配合仍待实机确认。
2026-11-03 docs: 补充外壳结构细节图和复现说明
    在外壳说明和打印指南中展示总览图与结构细节图，补充面板导向和电池压条剖面图。更新渲染脚本和打印包生成流程，确保文档图与 V12.9 文件同步。
2026-11-06 feat: 优化计时息屏与时钟显示
    新增完成后无操作自动息屏和等大时分秒显示，使用原分辨率纹理改善翻转清晰度，并修复计时、输入、显示与电源交互问题。同步更新检查记录、操作说明和待实机验收事项。
2026-11-06 fix: 修复完成后重启并优化旋转动画
    完成计时后点击立即重新开始当前面计时，恢复时钟页大小字布局，并以点采样小纹理改善翻转动画性能。同步记录编译、烧录结果及待实机验收事项。
2026-11-06 feat: 显示电量并优化充电线交互
    在电池图标旁显示电量百分比与充电标记，处理低电量和无效读数。调整 USB 插拔时的页面和计时行为，并同步记录充电观察、验证结果及待实机验收事项。
2026-11-06 docs: 整理成品展示与成本记录
    添加实物照片、演示视频及动图，在项目首页展示功能亮点与成本明细。整理硬件、外壳和验收说明，区分已观察成果与待验证事项。
2026-11-06 docs: 添加外壳模型与实物对比
    在项目首页展示外壳模型、实物电池仓和结构细节，并说明设计名义尺寸及实物验证边界。
